mekatronik-achmadi/fo_respiro/doc/plan_report/Readme.md

### Report in HTML view

[Report/Plan](https://htmlpreview.github.io/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)

[original site](https://htmlpreview.github.io/)
