mekatronik-achmadi/fo_respiro/new_pcb/REVISI.md

- ~~add Diode on USB BATT INPUT~~
- ~~footprint of FT232RL too small~~
- VCC on MC34 must be connected to VCC on COMP pin
- MC34 value L = 100uH, R1= 2k, R2 = 5k9, Rsc = 5R1, Rdrv = 180, Dschottky = 1n5819 (SS14)
- add VCC-GND LED indicator
- add Batt charging LED indicator with high R-LED
- add Diode on LASER V+
- add Diode on PhDiode V+
- reverse pin on LASER
- Core-Board: doubled-vias
- Core-Board: VDD-GND jumper too close
- GLCD GND-VCC (power) reversed
- LCD-EN header connected not in bottom
- GLCD-RST to VCC
- STM32F407 VREF+ connect to VDD
