mekatronik-achmadi/fo_respiro/doc/latex_doc/doc_jw.tex

\documentclass[12pt,]{book}
\usepackage[utf8]{inputenc}
\usepackage[T1]{fontenc}
\usepackage{mathptmx}
\usepackage{geometry}
\usepackage{mathtools}
\usepackage[english]{babel}
\usepackage{graphicx}
\usepackage[os=win]{menukeys}
\usepackage[figurename=Gambar]{caption}
\usepackage{hyperref}
\usepackage{minted}
\usepackage{float}
\usepackage{pdflscape}
\usepackage{pdfpages}

%\addto\captionsenglish{\renewcommand{\contentsname}{Daftar Isi}}

\hypersetup{
	colorlinks=true, %set true if you want colored links
	linktoc=all,     %set to all if you want both sections and subsections linked
	linkcolor=blue,  %choose some color if you want links to stand out
}

\geometry{
	a4paper,
	left=15mm,
	right=10mm,
	top=10mm,
	bottom=10mm,
}

\title{\Large \bf
	Technical Document (Preliminary Design)
}

\author{Achmadi ST s.MT}
\date{}

\begin{document}
	
	\maketitle
	\thispagestyle{empty}
	\pagestyle{empty}
	
	\newpage
	\tableofcontents
	
	\newpage
	\chapter{Joinwit}

	\section{Introduction}
	
	\hspace{10pt} This document explain essential part of development.
	In this development chapter, currently use Joinwit product (as is, no deep reverse engineer).
	All development files (including source of this document) available as open-sources at \url{https://github.com/mekatronik-achmadi/fo_respiro}
	
	The main hardware part section of development consist:
	\begin{itemize}
		\item Optical Power Meter module. Taken from product JW-3208
		\item Laser Source module. Taken from product JW-3109
		\item Custom Central Processor Unit. Using development board Cz-mini STM32F103Vx. Essenstial module consist:
		\begin{itemize}
			\item STM32F103Vx chip, an 32-bit armhf core chip
			\item LCD-TFT based on ILI9320 protocol  
		\end{itemize}
		\item Bluetooth Serial module HC-05
		\item 5v Power Source. Currently using a common powerbank 	
	\end{itemize}

	The main Software part section of development consist:
	\begin{itemize}
		\item a real-time multithreaded firmware based on ChibiOS/RT using both kernel scheduling and hardware abstraction layer.
		\item a desktop interface that data with interchange Custom CPU based Qt5 SDK
		\item a mobile apps interface that data with interchange Custom CPU based on Android SDK
	\end{itemize}

	\section{Hardware}
	
	\subsection{Optical Power Meter}
	This module is used to aquire any raw photonic signal or power.
	This module has no any modification or engineering, except geting ADC input signal that has voltage level compatible with STM32 series chip (custom CPU chip).
	Type and brand used is JW (Joinwit) 3208 series.
	
	\subsection{Laser Source}
	This module is used to provide laser signal/power. 
	This module has no any modification or engineering.
	Type and brand used is JW (Joinwit) 3109 series.
	
	\begin{figure}[h]
		\centering
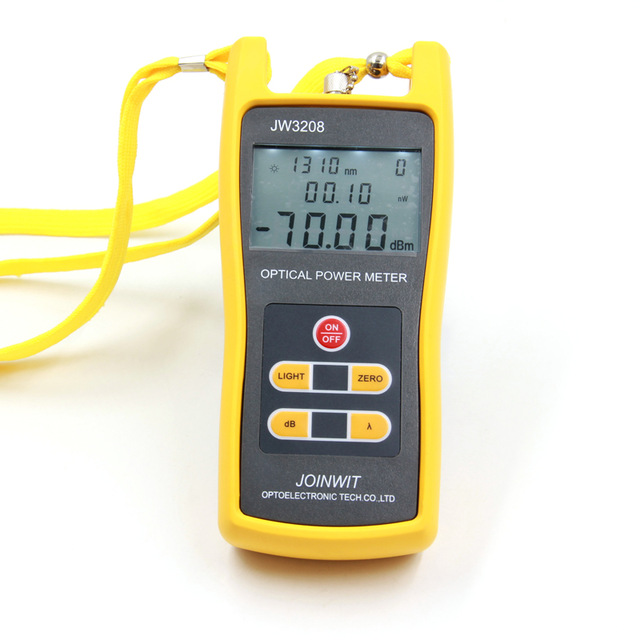
[picture p1: doc/latex_doc/images/jw3208.jpg]
		
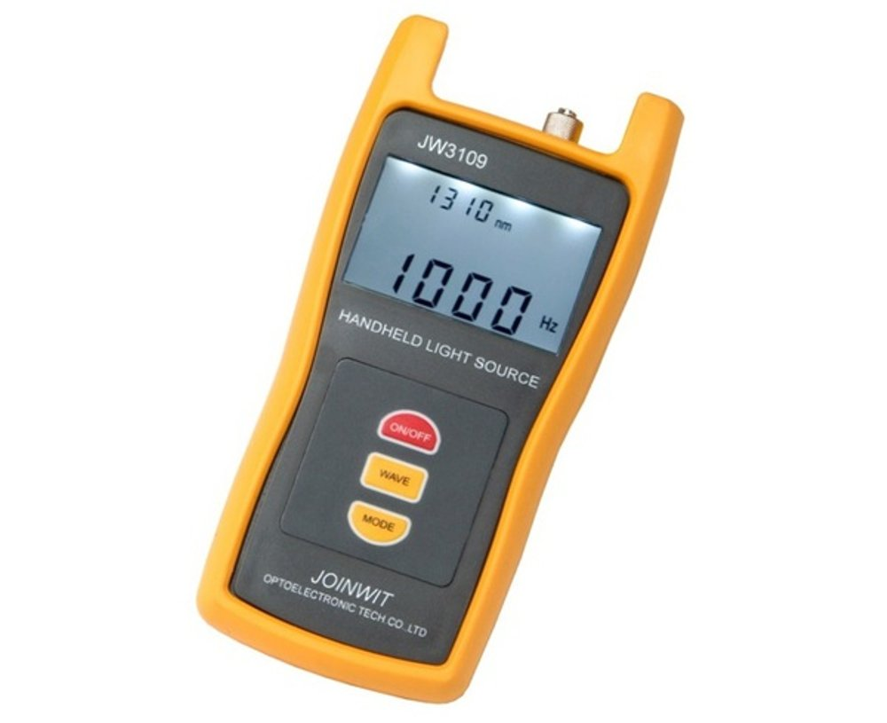
[picture p2: doc/latex_doc/images/jw3109.jpg]
		
		\caption{Instrumen JW3208 dan JW3109}
	\end{figure}
	
	\subsection{Custom Central Processing Unit}
	This module (development board )is used as central processing system.
	Type and brand used is CZ-miniSTM32F103Vx.
	
	Internal module used are consist:
	\begin{itemize}
		\item Analog to Digital Converter (ADC) with 12-bit data size to aquire input signal from Optical Power Meter.
		\item Serial data UART (both USB and HC-05) with 8-bit data size to communicate with outside of the chip.
		\item General digital I/O to control Laser Source module.
	\end{itemize}

	\begin{figure}[h]
		\centering
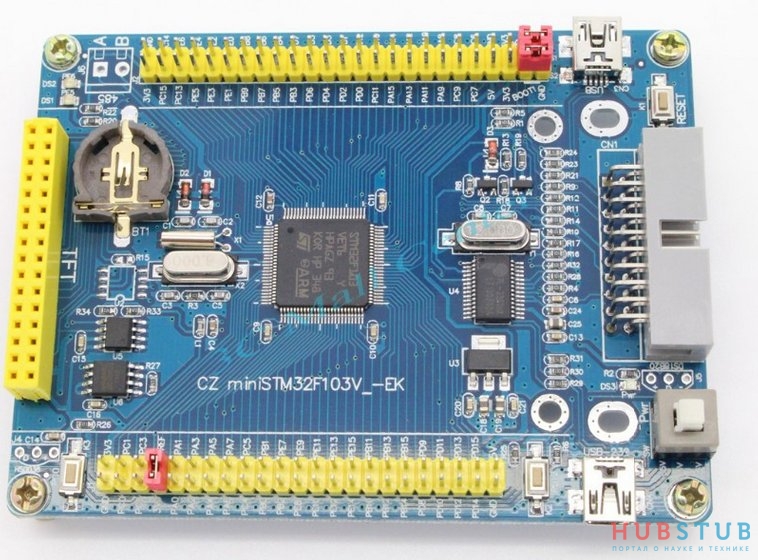
[picture p3: doc/latex_doc/images/ministm32f103.jpg]
		
		\caption{Development Board CZ miniSTM32F103Vx}
	\end{figure}

	\newpage
	\subsection{Bluetooth Serial}
	This module is used to provide communication feature with any device (either computer or mobile) that support Bluetooth radio communication. 
	Type and brand used is HC-05.
	
	\begin{figure}[h]
		\centering
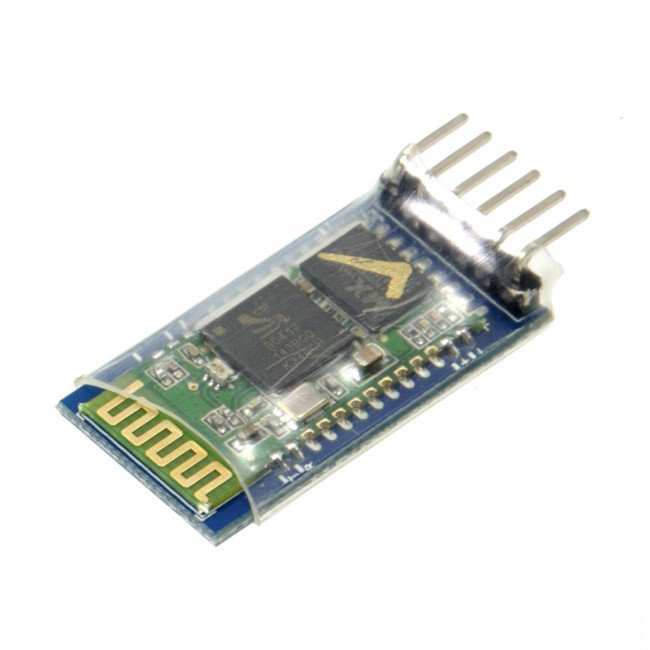
[picture p4: doc/latex_doc/images/hc-05.jpg]
		
		\caption{Module Bluetooth HC-05}
	\end{figure}

	\section{Hardware Bill of Material}
	
	Below are part list for purchasing purposes:
	\begin{itemize}
		\item Optical Power Meter JW-3208 from e-Bay: \url{https://www.ebay.com/p/Joinwit-Handheld-Optical-Power-Meter-JW3208/2191151148}
		\item Laser Source JW-3109 from e-Bay: \url{https://www.ebay.com/p/Jw3109-Handheld-Optical-Light-Source-FC-CONNETCTOR-Fiber-Optic-Tester1310-1550nm/1683352799}
		\item Development Board CZ-MiniSTM32F103Vx from Aliexpress: \url{http://www.aliexpress.com/item/FREE-SHIPPING-ARM-Cortex-M3-mini-stm32-stm32F103VEt6-Cortex-development-board-72MHz-512KFlash-64KRAM/32216480157.html}
		\item LCD-TFT ILI9320 from Aliexpress: \url{https://www.aliexpress.com/item/3-2-inch-37PIN-TFT-LCD-Screen-ILI9320-Drive-IC-240-RGB-320-No-Touch-Panel/32579843844.html}
		\item HC-05 Bluetooth RFComm module from Digiware: \url{http://digiwarestore.com/en/bluetooth/hc-05-bluetooth-module-432241.html}
	\end{itemize}	  
	
	\section{Software}
	
	\subsection{ChibiOS/RT}
	ChibiOS/RT is framework to build high quality firmware for many embedded system chips.
	In this work, both kernel and hardware abstraction are used.
	
	ChibiOS/RT Kernel is the high performance RTOS part of the ChibiOS embedded collection.
	Kernel RT has been designed with the idea of creating a very feature-complete RTOS that could excel in performance and code size.
	
	\begin{figure}[h]
		\centering
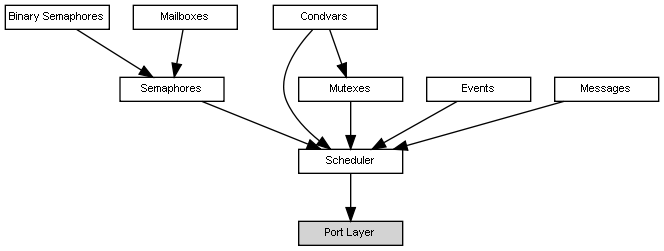
[picture p5: doc/latex_doc/images/chibios_kernel.png]
		
		\caption{ChibiOS Multithreading Kernel}
	\end{figure}
	
	\newpage
	The HAL component is meant to be an abstraction layer between the application and the underlying micro-controller hardware.
	HAL offers an high level API for accessing common MCU peripheral like GPIO, ADC, SPI and so on and also take care of clocks-related and board-level initializations.
	
	\begin{figure}[H]
		\centering
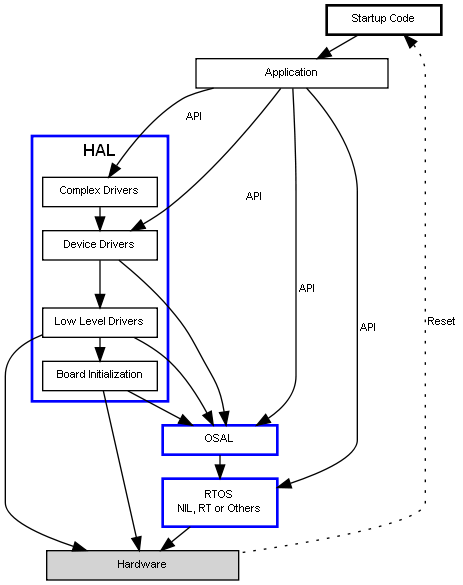
[picture p6: doc/latex_doc/images/chibios_hal_arch.png]
		
		\caption{ChibiOS Hardware Abstraction Layer}
	\end{figure}

	The main section of firmware consist:
	\begin{itemize}
		\item Analog to Digital Converter (ADC)
		\begin{figure}[H]
			\centering
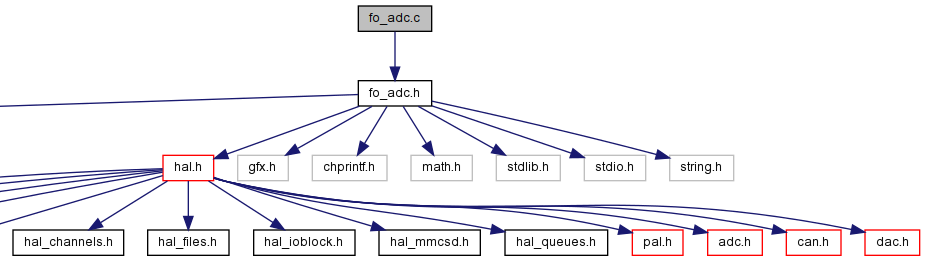
[picture p7: doc/latex_doc/images/jw_ch_adc.png]
			
			\caption{ADC depedencies diagram}
		\end{figure}
	
		\newpage
		\item Serial Shell Interface (both for Bluetooth and USB)
		\begin{figure}[H]
			\centering
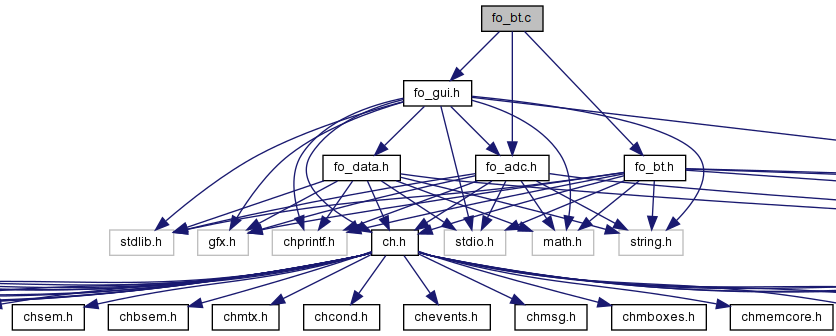
[picture p8: doc/latex_doc/images/jw_ch_bt.png]
			
			\caption{Bluetooth Serial depedencies diagram}
		\end{figure}
		\item Data Handling (include calibration)
		\begin{figure}[H]
			\centering
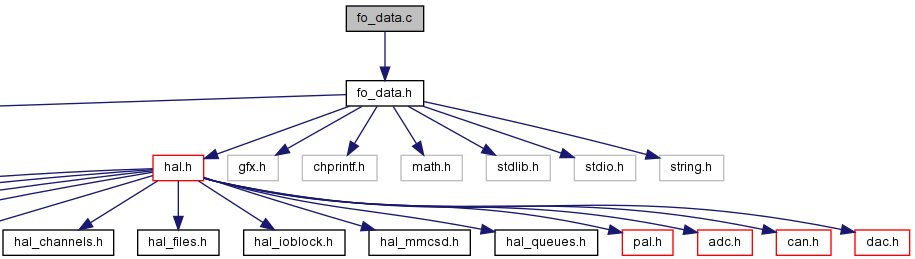
[picture p9: doc/latex_doc/images/jw_ch_data.png]
			
			\caption{Data handling depedencies diagram}
		\end{figure}
		\item LCD-GUI display (both graph and console)
		\begin{figure}[H]
			\centering
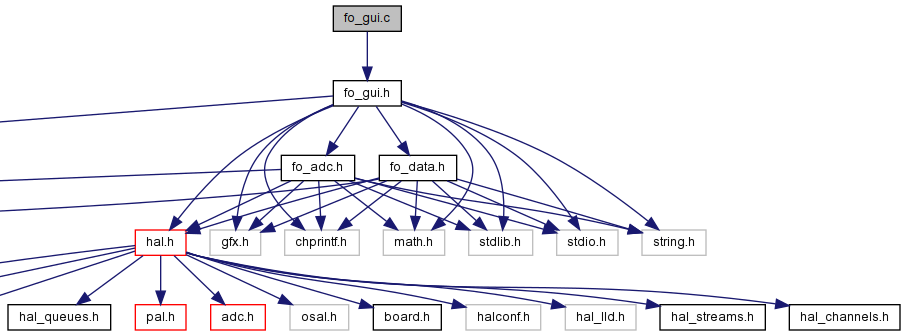
[picture p10: doc/latex_doc/images/jw_ch_gui.png]
			
			\caption{GUI depedencies diagram}
		\end{figure}		
	\end{itemize}
	
	\newpage
	\begin{landscape}
		By including ChibiOS API, all module dependecies can be described below:
		\begin{figure}[H]
			\centering
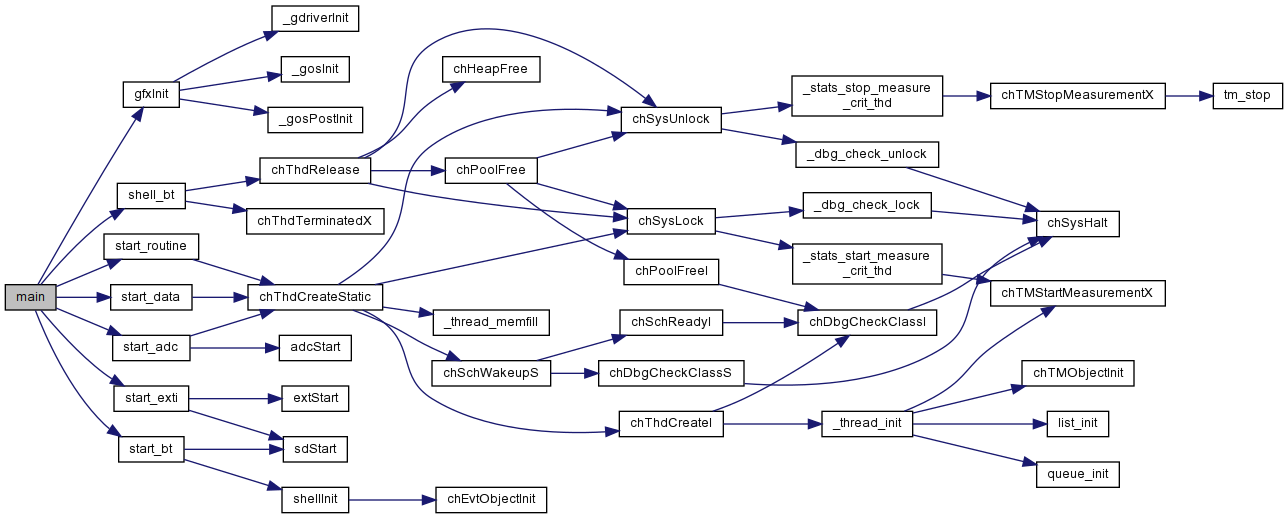
[picture p11: doc/latex_doc/images/jw_ch_main.png]
			
			\caption{Main source depedencies diagram}
		\end{figure}
	\end{landscape}

	\newpage	
	\subsection{Qt-based Desktop Interface}
	
	\subsection{Android Mobile Interface}
	
	\newpage
	\chapter{Prototype}
	
	\section{Introduction}
	
	\section{Hardware}
	
	\subsection{Core}
	Core STM32F103Vx
	\begin{figure}[H]
		\centering
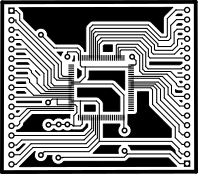
[picture p12: doc/latex_doc/images/old_core_Fcu.png]
		
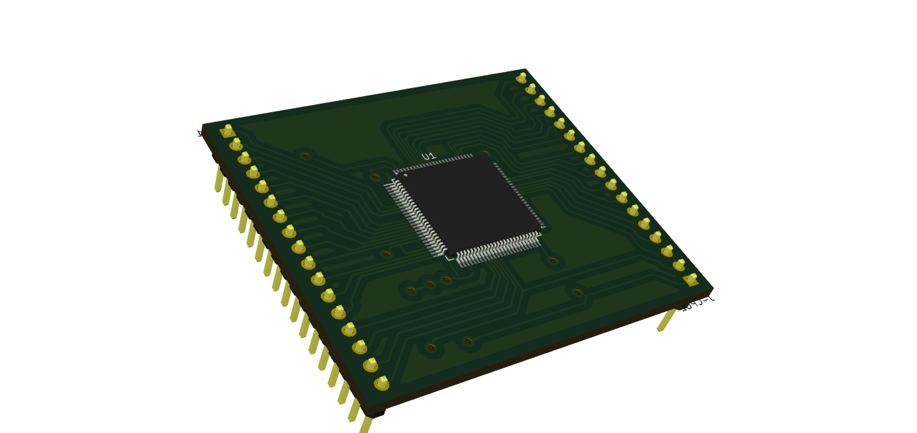
[picture p13: doc/latex_doc/images/old_core_3d.png]
		
		\caption{Core Board Layout and Model}
	\end{figure}

	\subsection{Mainboard}
	Core STM32F407Vx
	\begin{figure}[H]
		\centering
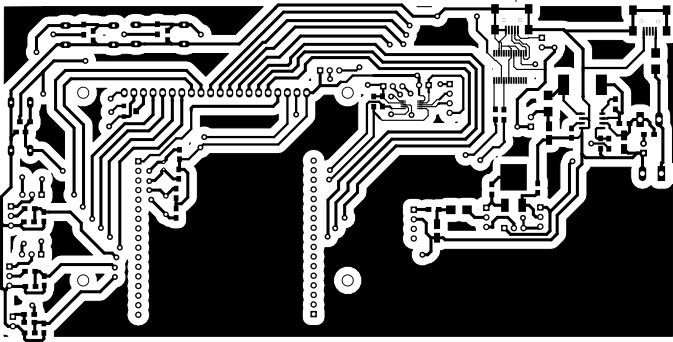
[picture p14: doc/latex_doc/images/old_board_Fcu.png]
		
		\caption{Core Board Layout Up}
	\end{figure}

	\begin{figure}[H]
		\centering
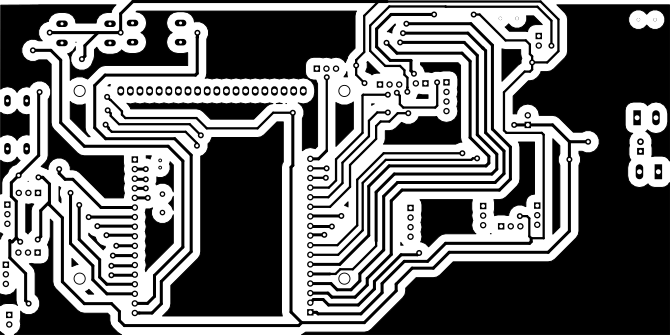
[picture p15: doc/latex_doc/images/old_board_Bcu.png]
		
		\caption{Core Board Layout Bottom}
	\end{figure}

	\begin{figure}[H]
		\centering
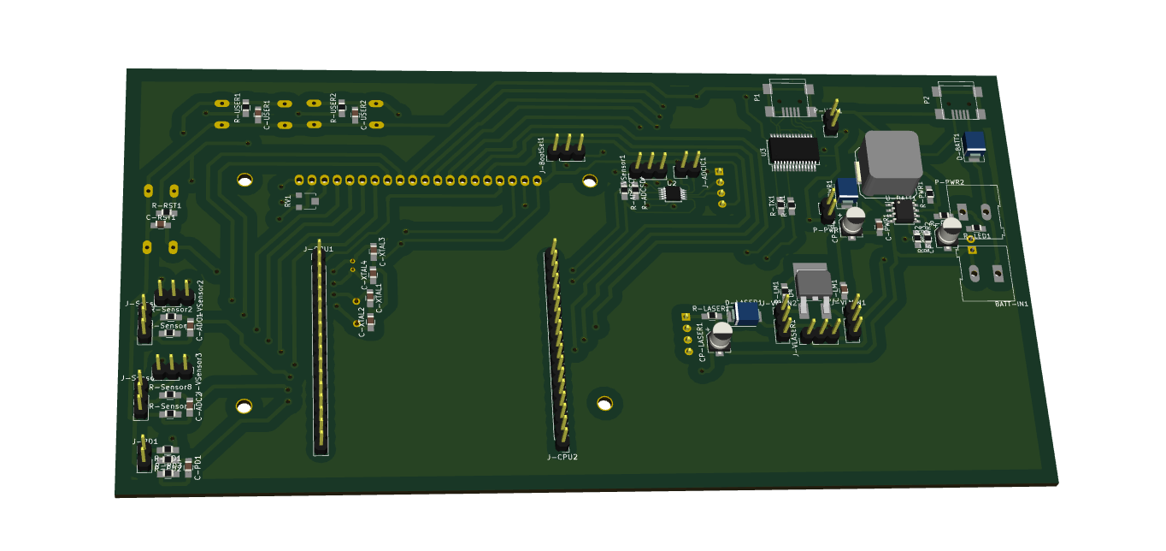
[picture p16: doc/latex_doc/images/old_board_F3d.png]
		
		\caption{Core Board Model Up}
	\end{figure}
	
	\begin{figure}[H]
		\centering
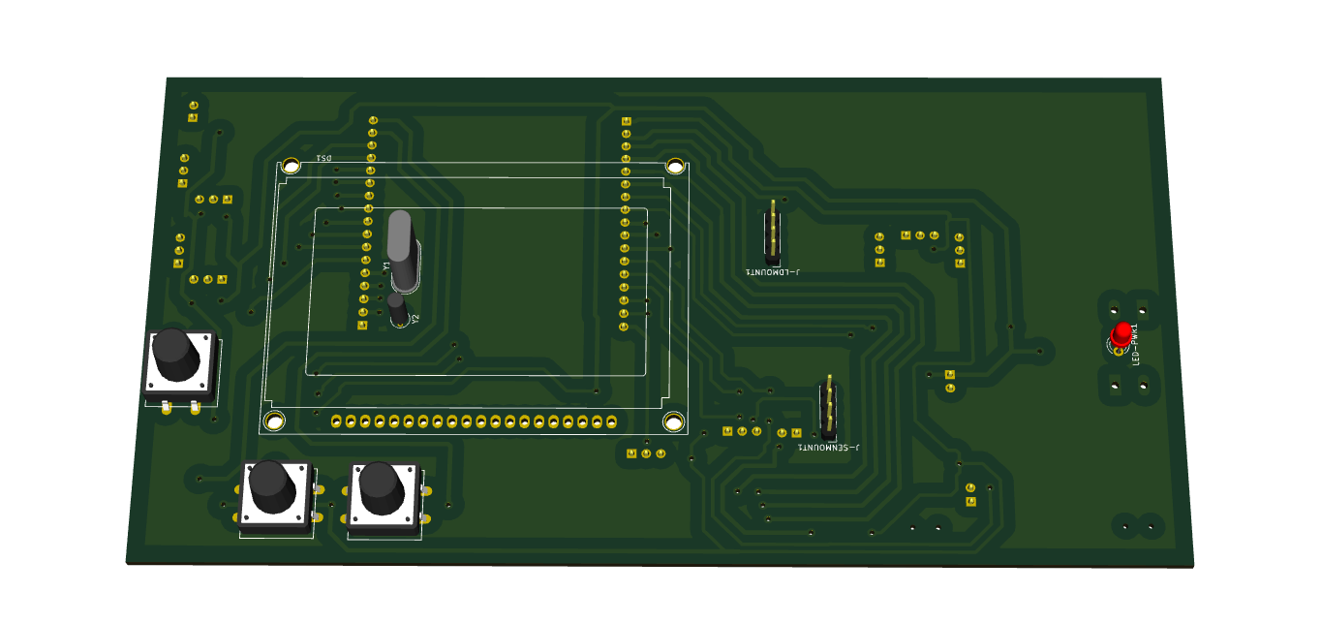
[picture p17: doc/latex_doc/images/old_board_B3d.png]
		
		\caption{Core Board Model Bottom}
	\end{figure}

	\newpage
	\begin{landscape}
		\includepdf[landscape=true]{images/schematic.pdf}
	\end{landscape}
	
	\section{Hardware Bill of Material}
	
	Below are part list for purchasing purposes:
	\begin{itemize}
		\item STM32F407VGT6 from Digiware: \url{http://digiwarestore.com/en/arm-core/stm32f407vgt6-131222.html}
		\item Graphic LCD 128x64 from Digiware: \url{http://digiwarestore.com/en/lcd-graphic/graphic-lcd-128x64-stn-yellow-green-background-yellow-green-backlight-780-x-700-x-130-712089.html} 
		\item R\_0805 330 from Digiware
		\item R\_0805 180 from Digiware
		\item R\_0805 12K from Digiware
		\item R\_0805 3K9 from Digiware
		\item R\_0805 R from Digiware
		\item R\_0805 10K from Digiware
		\item R\_0805 1K from Digiware
		\item MC33063/MC34063D  from Digiware
		\item FT232RL from Digiware
		\item H28 from Digiware
		\item Elco 100uF
		\item Elco 10uF
		\item USB Mini B
		\item LED\_0805 from Digiware
		\item C\_0805 1nF from Digiware
		\item Schottky Diode from Digiware
		\item PIN Photodiode module T-11-155-R-SFC-AGC from Digikey
		\item Laser module TRDFB-1550-P-X-Y from Digikey
	\end{itemize}
		
	\section{Software}
	
\end{document}
