mekatronik-achmadi/fo_respiro/doc/plan_report/Pasca_Foton.html

# Pasca Foton

Company: | Optic and Photonic Lab
Manager: | Rima Adiati Sari Ningrum
Start: | September 18, 2018
Finish: | December 18, 2018
Phase: | PrototypeDesigning
Report Date: | October 5, 2018

## Gantt Chart

WBS | Name | Work
1 | OPM - Find ADC line | 4d
2 | OPM - Find Gain | 4d
3 | Libur Wisuda | 7d
4 | OPM - Osci Test | 4d
5 | OPM - Control Design | 6d
6 | OLS - Find driver strcuture | 4d
7 | OLS - Power variance Test | 4d
8 | OLS - Control Design | 4d
9 | INT - Pre-Design | 7d
10 | INT - Alpha version build | 7d
11 | INT - Alpha Test | 7d
12 | SEN - Pre- Test | 7d
13 | INT - Alpha-Fabric build | 15d
14 | INT - Package Assembly | 7d

| | | | | | Week 39, 2018 | | | | | | | Week 40, 2018 | | | | | | | Week 41, 2018 | | | | | | | Week 42, 2018 | | | | | | | Week 43, 2018 | | | | | | | Week 44, 2018 | | | | | | | Week 45, 2018 | | | | | | | Week 46, 2018 | | | | | 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
18 | 19 | 20 | 21 | 22 | 23 | 24 | 25 | 26 | 27 | 28 | 29 | 30 | 1 | 2 | 3 | 4 | 5 | 6 | 7 | 8 | 9 | 10 | 11 | 12 | 13 | 14 | 15 | 16 | 17 | 18 | 19 | 20 | 21 | 22 | 23 | 24 | 25 | 26 | 27 | 28 | 29 | 30 | 31 | 1 | 2 | 3 | 4 | 5 | 6 | 7 | 8 | 9 | 10 | 11 | 12 | 13 | 14 | 15 | 16 | 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

## Tasks

WBS | Name | Start | Finish | Work | Complete | Cost | Assigned to
1 | OPM - Find ADC line | Sep 18 | Sep 21 | 4d | 100%
2 | OPM - Find Gain | Sep 20 | Sep 25 | 4d | 40%
3 | Libur Wisuda | Sep 24 | Oct 2 | 7d | 100%
4 | OPM - Osci Test | Oct 2 | Oct 5 | 4d | 60%
5 | OPM - Control Design | Oct 2 | Oct 9 | 6d | 30%
6 | OLS - Find driver strcuture | Oct 8 | Oct 11 | 4d | 0%
7 | OLS - Power variance Test | Oct 12 | Oct 17 | 4d | 0%
8 | OLS - Control Design | Oct 17 | Oct 22 | 4d | 0%
9 | INT - Pre-Design | Oct 22 | Oct 30 | 7d | 0%
10 | INT - Alpha version build | Oct 29 | Nov 6 | 7d | 0%
11 | INT - Alpha Test | Nov 5 | Nov 13 | 7d | 0%
12 | SEN - Pre- Test | Nov 12 | Nov 20 | 7d | 0%
13 | INT - Alpha-Fabric build | Nov 19 | Dec 7 | 15d | 0%
14 | INT - Package Assembly | Dec 7 | Dec 17 | 7d | 0%

## Resources

Name | Short name | Type | Group | Email | Cost
Osciloscope probe (2) | | Material | | http://lapantech.com/Hantek-PP-150-100-MHz-Oscilloscope-Probes-osiloskop | 600000
PCB Fabric | | Material | | CV MPI | 1000000

This file was generated by Planner (http://live.gnome.org/Planner/)
