mekatronik-achmadi/fo_respiro/doc/boost_battery.png

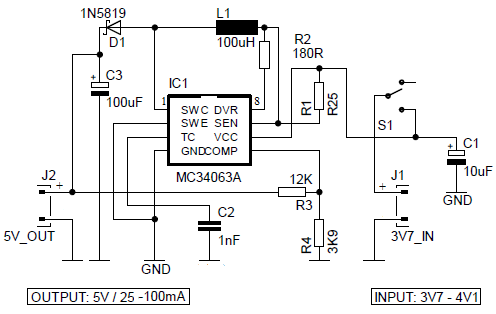
doc/boost_battery.png
