mekatronik-achmadi/fo_respiro/doc/Proposal/pics/batt_booster.png

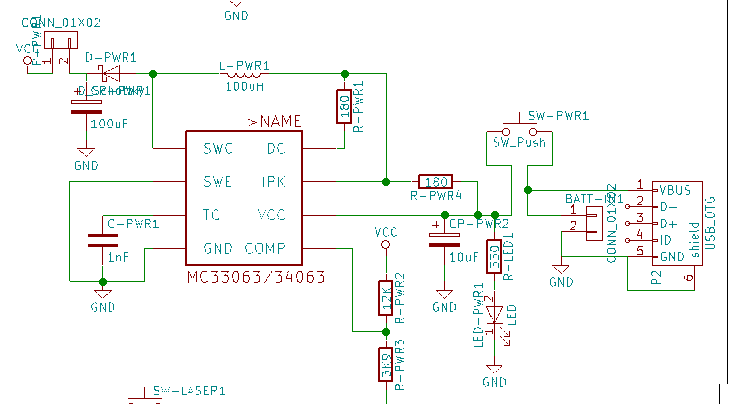
doc/Proposal/pics/batt_booster.png
