mekatronik-achmadi/fo_respiro/doc/Proposal/pics/box_back.jpg

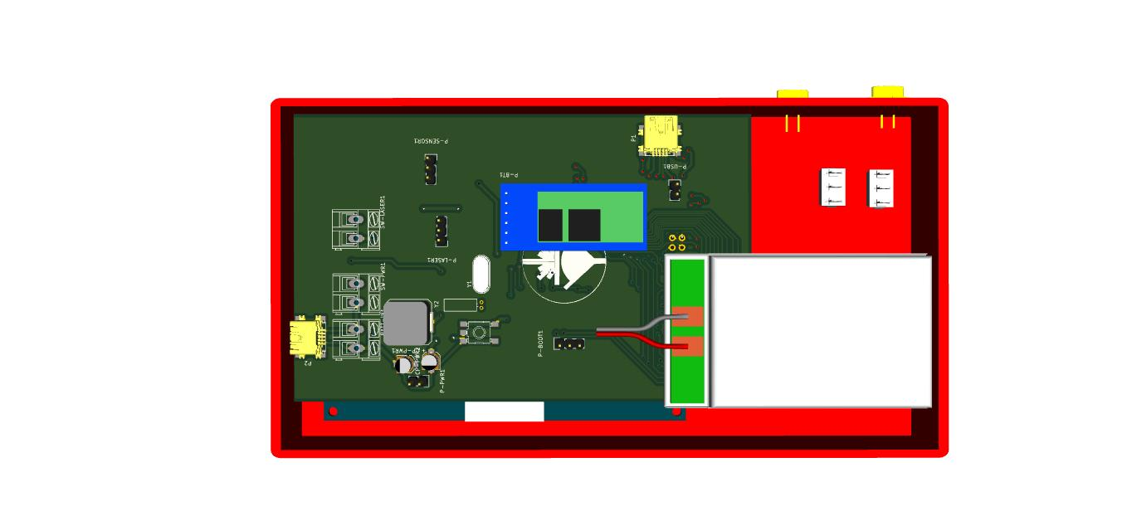
doc/Proposal/pics/box_back.jpg
