mekatronik-achmadi/fo_respiro/doc/Proposal/pics/box_front.jpg

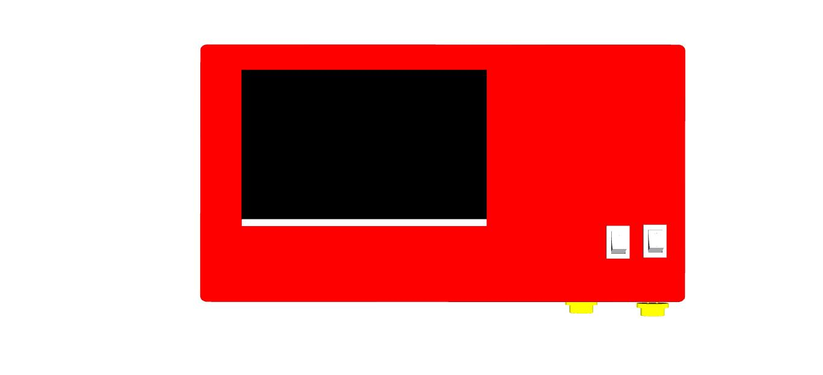
doc/Proposal/pics/box_front.jpg
