mekatronik-achmadi/fo_respiro/doc/Proposal/pics/diode.png

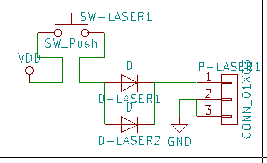
doc/Proposal/pics/diode.png
