mekatronik-achmadi/fo_respiro/new_pcb/docs/new_pcb.ods

Sheet: new_pcb
Id | Designator | Package | Quantity | Designation | Unit (Rp) | Price (Rp) | Supplier and ref
1 | BATT-IN1 | AK300-2 | 1 | CONN_01X02 | 4000 | 4000
2 | C-PWR1 | C_0805_HandSoldering | 1 | 1nF | 100 | 100
3 | C1,C2,C3 | C_0805_HandSoldering | 3 | C | 100 | 300
4 | DS1 | AG12864E | 1 | AG12864E | 236500 | 236500
5 | J-BootSel1,J-Sensor1,J-Sensor2,J-VSensor1,P-LASER1 | Pin_Header_Straight_1x03_Pitch2.54mm | 5 | CONN_01X03 | 1000 | 5000
6 | J-OA-Sensor1 | Pin_Header_Straight_1x04_Pitch2.54mm | 1 | CONN_01X04 | 1000 | 1000
7 | L-PWR1 | SELF-WE-PD-XXL | 1 | 100uH | 4500 | 4500
8 | LED-PWR1 | LED_0805 | 1 | LED | 1000 | 1000
9 | P1,P2 | USB_Mini-B | 2 | USB_OTG | 4000 | 8000
10 | R-LED1 | R_0805_HandSoldering | 1 | 330 | 1000 | 1000
11 | R-PWR1,R-PWR4 | R_0805_HandSoldering | 2 | 180 | 100 | 200
12 | R-PWR2 | R_0805_HandSoldering | 1 | 12K | 100 | 100
13 | R-PWR3 | R_0805_HandSoldering | 1 | 3K9 | 100 | 100
14 | R-RST1 | R_0805_HandSoldering | 1 | R | 100 | 100
15 | R-Sensor1,R-Sensor3 | R_0805_HandSoldering | 2 | 10K | 100 | 200
16 | R-Sensor2,R-Sensor4 | R_0805_HandSoldering | 2 | 1K | 100 | 200
17 | RV1 | Potentiometer_Trimmer-EVM3E | 1 | POT | 4000 | 4000
18 | SW-LASER1,SW-PWR1,SW-RST1 | AK300-2 | 3 | SW_Push | 4000 | 12000
19 | U-BATT1 | SOIC-8_3.9x4.9mm_Pitch1.27mm | 1 | MC33063/MC34063D_SO08 | 7000 | 7000
20 | U1 | LQFP-100_14x14mm_Pitch0.5mm | 1 | STM32F407VGTx | 212800 | 212800
21 | U2 | MSOP-10_3x3mm_Pitch0.5mm | 1 | H28 | 30000 | 30000
22 | U3 | TSSOP-28_4.4x9.7mm_Pitch0.65mm | 1 | FT232RL | 50000 | 50000
23 | D-LASER2 | D_MELF_Handsoldering | 1 | D | 1000 | 1000
24 | P-PWR1,P-USB1 | Pin_Header_Straight_1x02_Pitch2.54mm | 2 | CONN_01X02 | 1000 | 2000
25 | CP-PWR1 | CP_Elec_4x5.3 | 1 | 100uF | 500 | 500
26 | CP-PWR2 | CP_Elec_4x5.3 | 1 | 10uF | 500 | 500
27 | D-LASER1 | D_SMB_Standard | 1 | D | 500 | 500
28 | D-PWR1 | D_SMB_Standard | 1 | D_Schottky | 500 | 500
 | Total |  |  |  |  | 583100
 | Round-Up |  |  |  |  | 600000

Sheet: Primary
Id | Package | Quantity | Designation | Unit (Rp) | Price (Rp) | Supplier and ref
1 | AK300-2 | 1 | CONN_01X02 | 4000 | 4000
2 | C_0805_HandSoldering | 1 | 1nF | 100 | 100
3 | C_0805_HandSoldering | 3 | C | 100 | 300
4 | AG12864E | 1 | AG12864E | 236500 | 236500
5 | Pin_Header_Straight_1x03_Pitch2.54mm | 5 | CONN_01X03 | 1000 | 5000
6 | Pin_Header_Straight_1x04_Pitch2.54mm | 1 | CONN_01X04 | 1000 | 1000
7 | SELF-WE-PD-XXL | 1 | 100uH | 4500 | 4500
8 | LED_0805 | 1 | LED | 1000 | 1000
9 | USB_Mini-B | 2 | USB_OTG | 4000 | 8000
10 | R_0805_HandSoldering | 1 | 330 | 1000 | 1000
11 | R_0805_HandSoldering | 2 | 180 | 100 | 200
12 | R_0805_HandSoldering | 1 | 12K | 100 | 100
13 | R_0805_HandSoldering | 1 | 3K9 | 100 | 100
14 | R_0805_HandSoldering | 1 | R | 100 | 100
15 | R_0805_HandSoldering | 2 | 10K | 100 | 200
16 | R_0805_HandSoldering | 2 | 1K | 100 | 200
17 | Potentiometer_Trimmer-EVM3E | 1 | POT | 4000 | 4000
18 | AK300-2 | 3 | SW_Push | 4000 | 12000
19 | SOIC-8_3.9x4.9mm_Pitch1.27mm | 1 | MC33063/MC34063D_SO08 | 7000 | 7000
20 | LQFP-100_14x14mm_Pitch0.5mm | 1 | STM32F407VGTx | 212800 | 212800
21 | MSOP-10_3x3mm_Pitch0.5mm | 1 | H28 | 30000 | 30000
22 | TSSOP-28_4.4x9.7mm_Pitch0.65mm | 1 | FT232RL | 50000 | 50000
23 | D_MELF_Handsoldering | 1 | D | 1000 | 1000
24 | Pin_Header_Straight_1x02_Pitch2.54mm | 2 | CONN_01X02 | 1000 | 2000
25 | CP_Elec_4x5.3 | 1 | 100uF | 500 | 500
26 | CP_Elec_4x5.3 | 1 | 10uF | 500 | 500
27 | D_SMB_Standard | 1 | D | 500 | 500
28 | D_SMB_Standard | 1 | D_Schottky | 500 | 500
 |  |  |  |  | 583100
 |  |  |  |  | 600000

Sheet: DigiWare
NO | Komponen | Nilai | Kode | Jumlah
1 | STM32F407VGT6 | - | 131-222 | 1
2 | MC34063D | - | 161-023 | 2
3 | FT232RL | - | 166-019 | 1
4 | H28 | - | 151-082 | 2
5 | C 0805 | 22pF | 241-101 | Min
6 | C 0805 | 1nF | 241-106 | Min
7 | R 0805 | 300 O | 915-712 | Min
8 | R 0805 | 180 O | 915-704 | Min
9 | R 0805 | 10k O | 915-007 | Min
10 | R 0805 | 3k3 O | 915-009 | Min
11 | R 0805 | 12k O | 915-711 | Min
12 | R 0805 | 1k O | 915-014 | Min
13 | Pot SMD | 500k O | 219-031 | 4
14 | CPOL | 10uF | 242-238 | 4
15 | Diode SMB | - | 253-089 | 4
16 | Schottky SMB | - | 253-069 | 2

Sheet: SFE
NO | Komponen | Nilai | Kode | Jumlah
1 | LED 0805 Green | - | LED0302003 | 2
2 | LED 0805 Red | - | LED0302001 | 2
3 | USB Mini B | - | CONUSB005 | 4
4 | R 0805 | 330 O | R010203018 | Min
5 | R 0805 | 10K O | R010203033 | Min
6 | R 0805 | 12K O | R010203034 | Min
7 | POT SMD | 10K O | VR0102003 | 4
8 | D Schottky | SS34 | DR02002 | 4
9 | D Rectifier | M7 | DR02001 | 4
10 | L POWER SMD | 100uH | L0206004 | 4
11 | Battery 1sel
12 | Bigger LCD

Sheet: ISee
NO | Komponen | Nilai | Kode | Jumlah
1 | STM32F407VGT6 | - | 131-222 | 1
