mekatronik-achmadi/fo_respiro/new_pcb/docs/list.ods

no | Components | Shop | Amount | Unit | Price | URLs
1 | STM32F407VGT6 | Digiware | 1 | 212,800.00 IDR | 212,800.00 IDR | http://digiwarestore.com/en/arm-core/stm32f407vgt6-131222.html
2 | Graphic LCD 128x64 | Digiware | 1 | 236,500.00 IDR | 236,500.00 IDR | http://digiwarestore.com/en/lcd-graphic/graphic-lcd-128x64-stn-yellow-green-background-yellow-green-backlight-780-x-700-x-130-712089.html
