mekatronik-achmadi/fo_respiro/doc/latex_doc/images/schematic.pdf

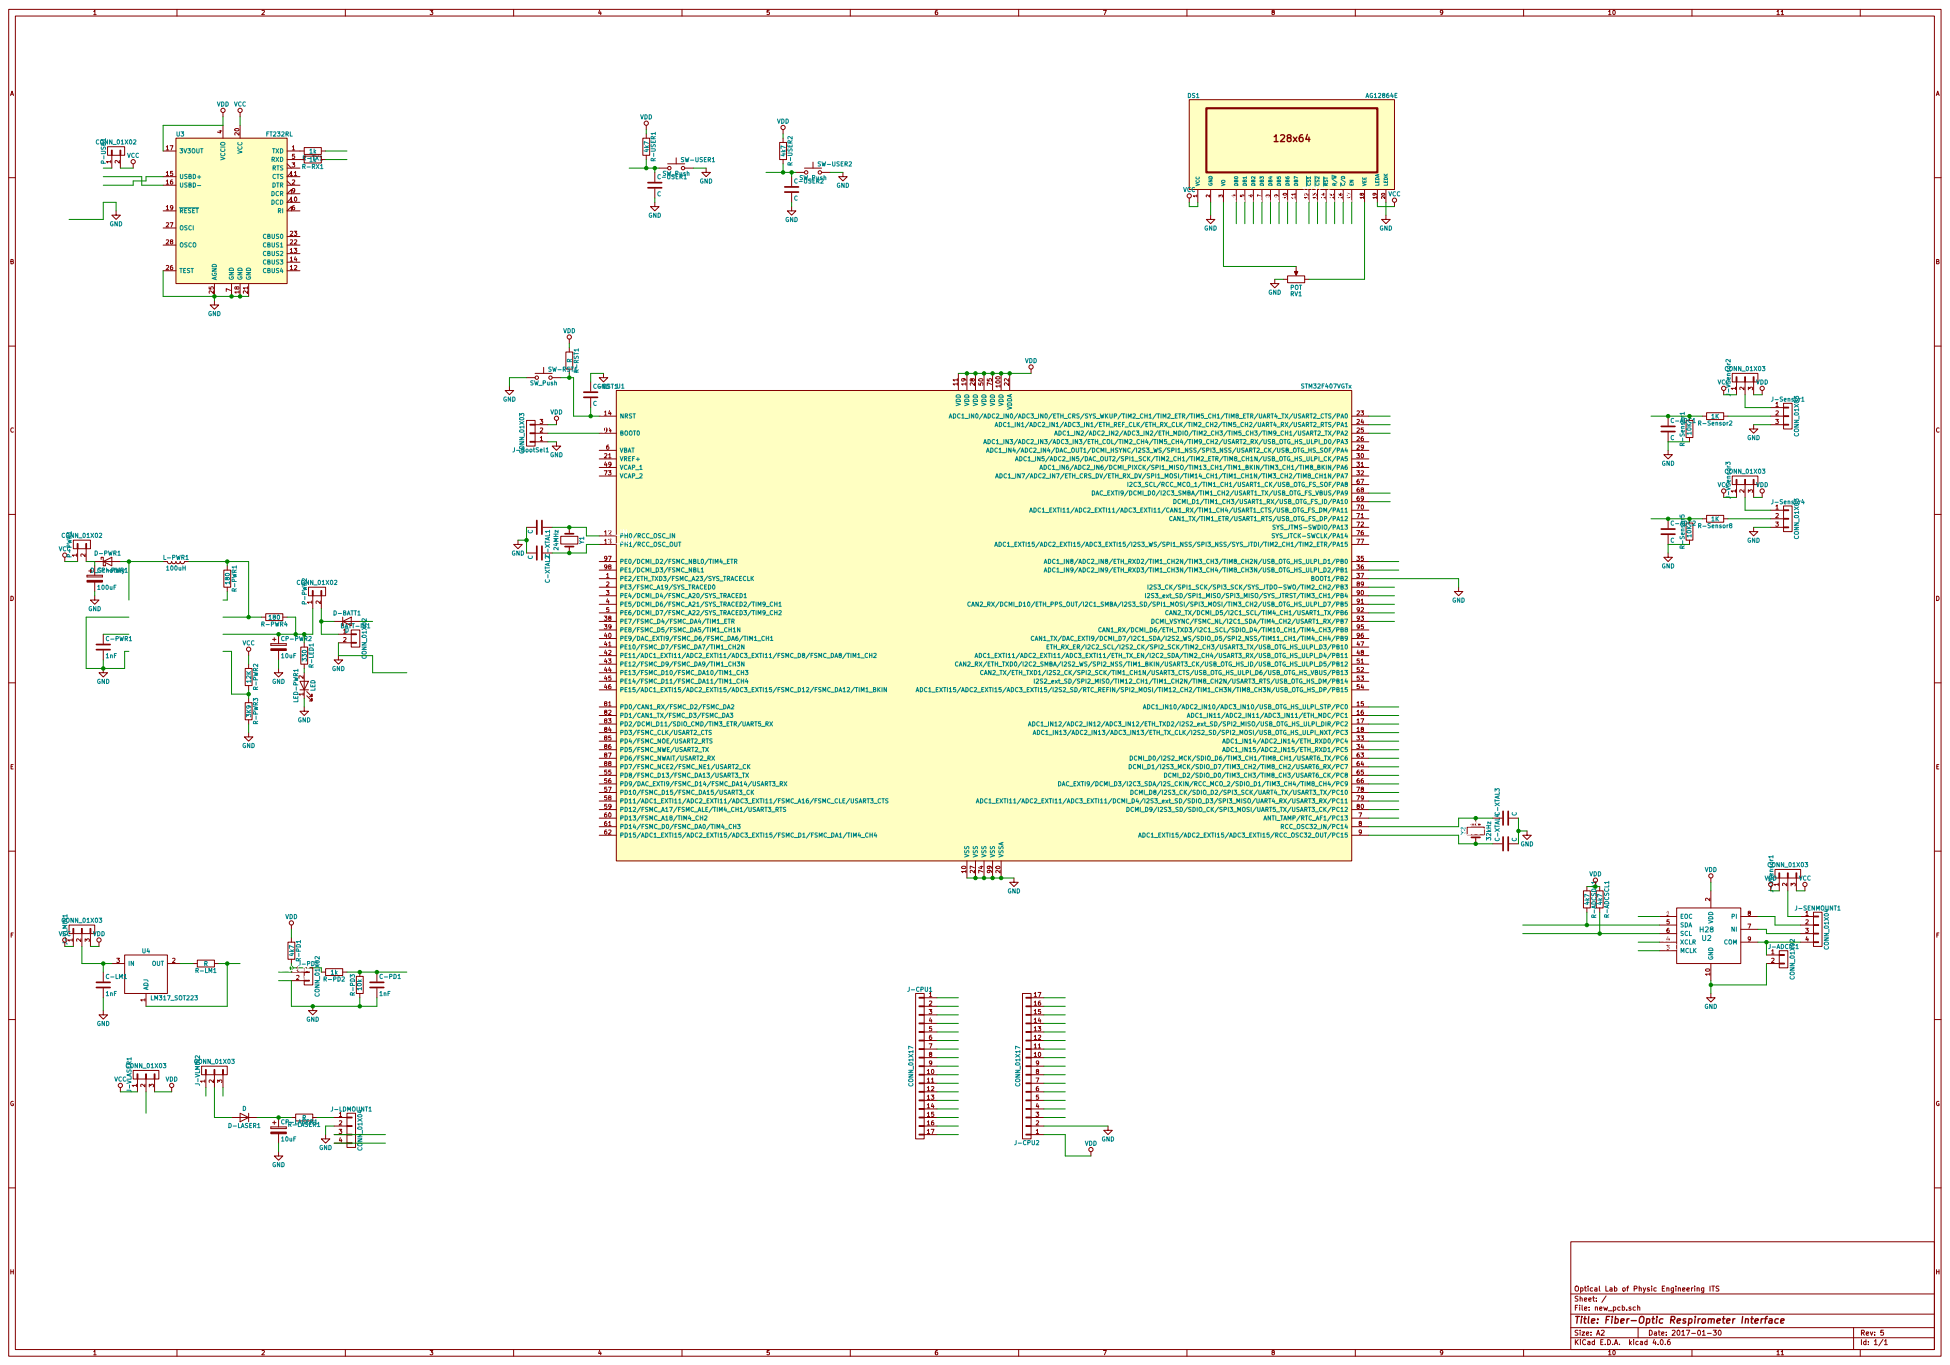
[picture p42: page 1]
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

7 DCR 9 DCD 10 VCC 20 CTS 11 GND 21 CBUS4 12 CBUS1 22 CBUS2 13 CBUS0 23 CBUS3 14 USBD+ 15 AGND 25 USBD- 16 TEST 26

3J-VSensor3 CONN_01X03 VCC VDD GND R-PD1 4k7 VDD GND

2 MCLK 3 XCLR 4 SDA 5 SCL 6 NI 7 PI 8 COM 9 GND 10 U2 H28

File: new_pcb.sch Sheet: / Optical Lab of Physic Engineering ITS

Id: 1/1 Title: Fiber-Optic Respirometer Interface
