mekatronik-achmadi/fo_respiro/firmware/cpu_joinwit/cubemx/cubemx.ioc

Mcu.UserName=STM32F103VETx
PA0-WKUP.Signal=ADCx_IN0
PA7.Signal=S_TIM3_CH2
PC14-OSC32_IN.Signal=RCC_OSC32_IN
PC15-OSC32_OUT.Signal=RCC_OSC32_OUT
