mekatronik-achmadi/fo_respiro/firmware/cpu_joinwit/main/fo_adc.h

/**
 * @file    fo_adc.h
 * @brief   ADC Handler header
 *
 * @addtogroup ADC
 * @{
 */

#ifndef FO_ADC_H
#define FO_ADC_H

#include "ch.h"
#include "hal.h"
#include "gfx.h"
#include "chprintf.h"
#include "math.h"
#include "stdlib.h"
#include "stdio.h"
#include "string.h"

#include "fo_data.h"

/**
 * @brief   define ADC channel.
 */
#define ADC_GRP1_NUM_CHANNELS   1

/**
 * @brief   define ADC matrix depth.
 */
#define ADC_GRP1_BUF_DEPTH      200

void start_adc(void);

#endif // FO_ADC_H

/** @} */
