mekatronik-achmadi/fo_respiro/firmware/cpu_joinwit/main/gfxconf.h

/**
 * This file has a different license to the rest of the uGFX system.
 * You can copy, modify and distribute this file as you see fit.
 * You do not need to publish your source modifications to this file.
 * The only thing you are not permitted to do is to relicense it
 * under a different license.
 */

/**
 * Copy this file into your project directory and rename it as gfxconf.h
 * Edit your copy to turn on the uGFX features you want to use.
 * The values below are the defaults. You should delete anything
 * you are leaving as default.
 *
 * Please use spaces instead of tabs in this file.
 */

#ifndef _GFXCONF_H
#define _GFXCONF_H

/* The operating system to use. One of these must be defined - preferably in your Makefile */
#define GFX_USE_OS_CHIBIOS      GFXON

/* GFX sub-systems to turn on */
#define GFX_USE_GDISP			GFXON
#define GFX_USE_GWIN			GFXON
#define GFX_USE_GMISC			GFXON
#define GFX_USE_GTIMER          GFXON
#define GFX_USE_GQUEUE          GFXON

/* Features for the GDISP sub-system. */
#define GDISP_NEED_VALIDATION	GFXON
#define GDISP_NEED_CLIP			GFXON
#define GDISP_NEED_TEXT			GFXON
#define GDISP_NEED_MULTITHREAD	GFXON
#define GDISP_NEED_CONTROL      GFXON
#define GDISP_INCLUDE_FONT_UI2	GFXON
#define GDISP_NEED_STARTUP_LOGO	GFXOFF

/* Features for the GWIN subsystem. */
#define GWIN_NEED_WINDOWMANAGER	GFXON
#define GWIN_NEED_GRAPH			GFXON
#define GWIN_NEED_CONSOLE		GFXON
    #define GWIN_CONSOLE_ESCSEQ             GFXON
    #define GWIN_CONSOLE_USE_HISTORY        GFXON
    #define GWIN_CONSOLE_HISTORY_AVERAGING	GFXON
    #define GWIN_CONSOLE_HISTORY_ATCREATE	GFXON

/* Features for the GQUEUE subsystem. */
#define GQUEUE_NEED_ASYNC       GFXON

/* Features for the GMISC subsystem. */
#define GMISC_NEED_FASTTRIG         GFXON
#define GMISC_NEED_MATRIXFLOAT2D    GFXON
#define GMISC_NEED_MATRIXFIXED2D    GFXON

#endif /* _GFXCONF_H */
