mekatronik-achmadi/fo_respiro/new_firmware/fo_shell.c

#include "fo_shell.h"

/*===========================================================================*/
/* Command line related.                                                     */
/*===========================================================================*/

static void cmd_mem(BaseSequentialStream *chp, int argc, char *argv[]) {
  size_t n, size;

  (void)argv;
  if (argc > 0) {
    chprintf(chp, "Usage: mem\r\n");
    return;
  }
  n = chHeapStatus(NULL, &size);
  chprintf(chp, "core free memory : %u bytes\r\n", chCoreGetStatusX());
  chprintf(chp, "heap fragments   : %u\r\n", n);
  chprintf(chp, "heap free total  : %u bytes\r\n", size);
}

static void cmd_threads(BaseSequentialStream *chp, int argc, char *argv[]) {
  static const char *states[] = {CH_STATE_NAMES};
  thread_t *tp;

  (void)argv;
  if (argc > 0) {
    chprintf(chp, "Usage: threads\r\n");
    return;
  }
  chprintf(chp, "    addr    stack prio refs     state time\r\n");
  tp = chRegFirstThread();
  do {
    chprintf(chp, "%08lx %08lx %4lu %4lu %9s\r\n",
            (uint32_t)tp, (uint32_t)tp->p_ctx.r13,
            (uint32_t)tp->p_prio, (uint32_t)(tp->p_refs - 1),
            states[tp->p_state]);
    tp = chRegNextThread(tp);
  } while (tp != NULL);
}

/*===========================================================================*/
/* Command line global variables.                                               */
/*===========================================================================*/

static const ShellCommand commands[] = {
  {"mem", cmd_mem},
  {"threads", cmd_threads},
  {NULL, NULL}
};

static const ShellConfig shell_cfg = {
  (BaseSequentialStream *)&SD1,
  commands
};

thread_t *shelltp = NULL;

/*===========================================================================*/
/* Usable functions.                                                         */
/*===========================================================================*/

void FO_Shell_Init(void){
    FO_Uart_Init();
    shellInit();
}

void FO_Shell_Run(void){
    if (!shelltp)
          shelltp = shellCreate(&shell_cfg, SHELL_WA_SIZE, NORMALPRIO);
        else if (chThdTerminatedX(shelltp)) {
          chThdRelease(shelltp);
          shelltp = NULL;
        }
        chThdSleepMilliseconds(1000);
}
