mekatronik-achmadi/fo_respiro/firmware/cpu_joinwit/main/fo_gui.c

/**
 * @file    fo_gui.c
 * @brief   Display GUI code
 *
 * @addtogroup GUI
 * @{
 */

#include "fo_gui.h"

/*===========================================================================*/
/* IMPORT DATA PART                                                          */
/*===========================================================================*/

extern adcsample_t adc0;
extern point vdata[N_DATA];
extern adcsample_t vcurr,vprev,dval;
extern icucnt_t Tchange;
extern uint8_t run_mode;
extern uint8_t rdata_ful;

/*===========================================================================*/
/* GRAPH PART                                                                */
/*===========================================================================*/

/**
 * @brief   object for overall graphic GUI
 */
static GGraphObject g;

/**
 * @brief   graphic line configuration
 */
static GGraphStyle GraphLine = {
    { GGRAPH_POINT_DOT, 10, White },          // Point
    { GGRAPH_LINE_SOLID, 10, White },          // Line
    { GGRAPH_LINE_SOLID, 0, Gray },        // X axis
    { GGRAPH_LINE_SOLID, 0, Gray },        // Y axis
    { GGRAPH_LINE_DOT, 5, Gray, 50 },      // X grid
    { GGRAPH_LINE_DOT, 5, Gray, 50 },     // Y grid
    GWIN_GRAPH_STYLE_POSITIVE_AXIS_ARROWS   // Flags
};

/*===========================================================================*/
/* DRAWING PART                                                              */
/*===========================================================================*/

/**
 * @brief   object for graphic and console window
 */
GHandle     gh,gc;

/**
 * @brief   console string variable
 */
char txt_adc0[16];

/**
 * @brief   Main GUI routine function
 */
static void gui_routine(void){

    gwinGraphStartSet(gh);
    gwinGraphDrawAxis(gh);
    gwinGraphDrawPoints(gh, vdata, sizeof(vdata)/sizeof(vdata[0]));

    if(run_mode==RUN_STATE)chsnprintf(txt_adc0,16,"RUN  |");
    else if(run_mode==PAUSE_STATE)chsnprintf(txt_adc0,16,"STOP |");
    gwinPrintf(gc, txt_adc0);

    chsnprintf(txt_adc0,16,"V=%4i |",vcurr);
    gwinPrintf(gc, txt_adc0);

    chsnprintf(txt_adc0,16," ddV=%4i |",dval);
    gwinPrintf(gc, txt_adc0);

    chsnprintf(txt_adc0,16," T=%6i |",Tchange);
    gwinPrintf(gc, txt_adc0);

    chsnprintf(txt_adc0,16," F=%1i",rdata_ful);
    gwinPrintf(gc, txt_adc0);

#if USE_FAST_REFRESH
    gfxSleepMicroseconds(DISP_SHOW_DELAY);
#else
    gfxSleepMilliseconds(SLOW_REFRESH_DELAY);
#endif

    gwinClear(gh);
    gwinClear(gc);
}


static THD_WORKING_AREA(waDraw, 256);
#define ThdFunc_Graph THD_FUNCTION

/**
 * @brief   Main Draw graph routine thread.
 */
static ThdFunc_Graph(thdDraw, arg) {
    font_t	    gfont;

    (void)arg;
    chRegSetThreadName("drawgraph");

    gfont = gdispOpenFont("UI2");
    gwinSetDefaultFont(gfont);

    {
      GWindowInit wi;
      gwinClearInit(&wi);

      wi.show = true;

      wi.x = 0;
      wi.y = 0;
      wi.width = gdispGetWidth();
      wi.height = (gdispGetHeight()/16)*15;
      gh = gwinGraphCreate(&g, &wi);

      wi.x = 0;
      wi.y = (gdispGetHeight()/16)*15;;
      wi.width = gdispGetWidth();
      wi.height = (gdispGetHeight()/16);

      gc = gwinConsoleCreate(0, &wi);

    }

  gwinGraphSetOrigin(gh, 0, 0);
  gwinGraphSetStyle(gh, &GraphLine);

  gwinClear(gc);
  gwinPrintf(gc, "System Ready \n");
  gwinGraphStartSet(gh);
  gwinGraphDrawAxis(gh);

#if DRAW_MODE==0
    uint16_t    i;

    gwinGraphStartSet(gh);
    gwinGraphDrawAxis(gh);

    for(i = 0; i < gwinGetWidth(gh)*5*2; i++) {
        gwinGraphDrawPoint(gh, i/5-gwinGetWidth(gh)/2, 20*sin(2*0.8*GFX_PI*i/180));
    }
    while(1);
#endif

#if DRAW_MODE==1

    while (true) {
        gui_routine();
    }
#endif

}

/*===========================================================================*/
/* INIT PART                                                                 */
/*===========================================================================*/

/**
 * @brief   Start GUI routine
 */
void start_routine(void){
    gdispSetOrientation(GDISP_ROTATE_0);
    chThdCreateStatic(waDraw, sizeof(waDraw),	NORMALPRIO, thdDraw, NULL);
}

/** @} */
