mekatronik-achmadi/fo_respiro/(commit log)

2017-01-30 pcb route start
2017-02-01 PCB Progress
    [for.kicad_pcb, for.sch]
2017-02-01 PCB done
    [for.kicad_pcb, for.sch]
2017-02-01 3d model
    [for_hc05.kicad_pcb]
2017-02-01 all 3D on PCB done
    [for_lcd.kicad_pcb]
2017-02-01 pcb lcd done
2017-02-01 pcb all done
    [for_usb.kicad_pcb]
2017-02-01 model box 3d
    [assembly.fcstd, box.fcstd]
2017-02-02 model 3d
    [for_usb.kicad_pcb]
2017-02-02 box 3d
    [box.fcstd, for_cover.kicad_pcb]
2017-02-02 model 3d done
    [box.fcstd, box.step, for_cover.kicad_pcb, laser.step]
2017-10-05 new design
    [new_pcb.kicad_pcb, new_pcb.sch]
2017-10-13 progres hardware oke
    [new_pcb.kicad_pcb, print.kicad_pcb, stm32f4.kicad_pcb]
2017-10-15 stm32 ks0108 non-ugfx
2017-10-17 ADC always on full
2017-10-17 solusi ADC VREF+
2017-10-29 laser only
2017-11-02 thorlab sensor addon
    [thorlab.kicad_pcb, thorlab.sch]
2018-10-02 old project re-foldered
    [laser.kicad_pcb, list.ods, new_pcb.csv, new_pcb.kicad_pcb, new_pcb.ods, new_pcb.sch, opm.kicad_pcb, opm.sch]
2018-10-03 ADC API
2018-10-03 try display ADC
2018-10-03 ADC data source
2018-10-03 try ADC feed
2018-10-03 ADC belum tampil
2018-10-05 ADC Graph
2018-10-05 ADC autorun OK
2018-10-10 use single ADC
2018-10-11 stm32 broadcast adc data
2018-10-19 calibration work on uW (not nW)
2018-10-25 usb distributor
    [pwr_dist.kicad_pcb, pwr_dist.sch]
2019-01-06 last progress
    [pwr_dist.kicad_pcb]
2020-05-06 prototype counter
2020-05-31 test to real sensor
2020-06-01 doxygen threads as functions
